rbrian/uChaser/README.md

# uFollow
Follow the project here: https://hackaday.io/project/190427-uchaser-ultrasonic-following-control-system
