rbrian/uChaser/prototype/Boards/TXRX BOM.xlsx

Sheet: Transmit US
Source: | D:\Projects\Ultrasonic-Direction-Finder-Module\Boards\Transmit US\Transmit US.kicad_sch
Date: | 2022-05-10 21:03
Tool: | Eeschema (6.0.2)
Generator: | C:\Program Files\KiCad\6.0\bin\scripting\plugins/bom_csv_grouped_by_value.py
Component Count: | 20
Individual Components:
Item | Qty | Reference(s) | Value | LibPart | Footprint | Datasheet | DK PN | MFG | MFG PN
 |  | C1 | 1u | Device:C | Capacitor_SMD:C_0603_1608Metric_Pad1.08x0.95mm_HandSolder | ~ | 478-1412-1-ND | AVX | 0805ZD105KAT2A
 |  | C2 | 1u | Device:C | Capacitor_SMD:C_0603_1608Metric_Pad1.08x0.95mm_HandSolder | ~ | 478-12799-1-ND | AVX | 0805ZD105KAT2A
 |  | C3 | 1u | Device:C | Capacitor_SMD:C_0603_1608Metric_Pad1.08x0.95mm_HandSolder | ~ | 478-1412-1-ND | AVX | 0805ZD104KAT2A
 |  | C4 | 1u | Device:C | Capacitor_SMD:C_0603_1608Metric_Pad1.08x0.95mm_HandSolder | ~ | 478-1412-1-ND | AVX | 0805ZD105KAT2A
 |  | C5 | 1u | Device:C | Capacitor_SMD:C_0603_1608Metric_Pad1.08x0.95mm_HandSolder | ~ | 478-1412-1-ND | AVX | 0805ZD105KAT2A
 |  | FID1 | Fiducial | Mechanical:Fiducial | Fiducial:Fiducial_1mm_Mask2mm | ~
 |  | FID2 | Fiducial | Mechanical:Fiducial | Fiducial:Fiducial_1mm_Mask2mm | ~
 |  | FID3 | Fiducial | Mechanical:Fiducial | Fiducial:Fiducial_1mm_Mask2mm | ~
 |  | H1 | GND | Mechanical:MountingHole_Pad | TestPoint:TestPoint_Keystone_5005-5009_Compact | ~
 |  | H2 | MountingHole | Mechanical:MountingHole | MountingHole:MountingHole_3.2mm_M3 | ~
 |  | H3 | MountingHole | Mechanical:MountingHole | MountingHole:MountingHole_3.2mm_M3 | ~
 |  | H4 | MountingHole | Mechanical:MountingHole | MountingHole:MountingHole_3.2mm_M3 | ~
 |  | H5 | MountingHole | Mechanical:MountingHole | MountingHole:MountingHole_3.2mm_M3 | ~
 |  | J1 | Phoenix 1984620 | Connector:Screw_Terminal_01x03 | Connector_PinHeader_2.54mm:PinHeader_1x03_P2.54mm_Vertical | ~
 |  | LS1 | USTransducer | uFinder:USTransducer | uFinder:ULTRASONIC_16MM
 |  | R1 | 0 | Device:R_US | Resistor_SMD:R_0603_1608Metric_Pad0.98x0.95mm_HandSolder | ~ | 311-51.0CRCT-ND | Yageo | RC0805FR-0751RL
 |  | R2 | 0 | Device:R_US | Resistor_SMD:R_0603_1608Metric_Pad0.98x0.95mm_HandSolder | ~ | 311-51.0CRCT-ND | Yageo | RC0805FR-0751RL
 |  | R3 | NP | Device:R_US | Resistor_SMD:R_0603_1608Metric_Pad0.98x0.95mm_HandSolder | ~ | NA | NA | NA
 |  | U1 | 74AHC1G04 | uFinder:74AHC1G04 | Package_TO_SOT_SMD:SOT-353_SC-70-5_Handsoldering | https://www.diodes.com/assets/Datasheets/74AHC1G04.pdf
 |  | U2 | MAX232 | Interface_UART:MAX232 | Package_SO:TSSOP-16_4.4x5mm_P0.65mm | https://www.renesas.com/us/en/document/dst/icl3221-icl3222-icl3223-icl3232-icl3241-icl3243-datasheet | ICL3232IVZ-ND | Renesas | ICL3232IVZ
Collated Components:
 |  |  |  |  |  |  |  |  |  |  | Num Boards | 12
Item | Qty | Reference(s) | Value | LibPart | Footprint | Datasheet | DK PN | MFG | MFG PN | Cost (10+) | Ext Cost | Notes
1 | 5 | C1, C2, C3, C4, C5 | 1u | Device:C | Capacitor_SMD:C_0603_1608Metric_Pad1.08x0.95mm_HandSolder | ~ | 1276-1102-1-ND | Samsung | CL10A105KA8NNNC | 0.034 | 2.04
2 | 3 | FID1, FID2, FID3 | Fiducial | Mechanical:Fiducial | Fiducial:Fiducial_1mm_Mask2mm | ~ | NA | NA | NA | 0 | 0
3 | 1 | H1 | GND | Mechanical:MountingHole_Pad | TestPoint:TestPoint_Keystone_5005-5009_Compact | ~ | 36-1041-ND | Keystone | 1041 | 0.2632 | 3.1584
4 | 4 | H2, H3, H4, H5 | MountingHole | Mechanical:MountingHole | MountingHole:MountingHole_3.2mm_M3 | ~ | NA | NA | NA | 0 | 0
5 | 1 | J1 | Phoenix 1984620 | Connector:Screw_Terminal_01x03 | Connector_PinHeader_2.54mm:PinHeader_1x03_P2.54mm_Vertical | ~ | 277-1722-ND | Phoenix | 1984620 | 0.782 | 9.384
6 | 1 | LS1 | USTransducer | uFinder:USTransducer | uFinder:ULTRASONIC_16MM |  |  |  |  |  | 0 | Amazon
7 | 2 | R1, R2 | 0 | Device:R_US | Resistor_SMD:R_0603_1608Metric_Pad0.98x0.95mm_HandSolder | ~ | 311-0.0HRCT-ND | Yageo | RC0603FR-070RL | 0.018 | 0.432
8 | 1 | R3 | NP | Device:R_US | Resistor_SMD:R_0603_1608Metric_Pad0.98x0.95mm_HandSolder | ~ | NA | NA | NA | 0 | 0
9 | 1 | U1 | 74AHC1G04 | uFinder:74AHC1G04 | Package_TO_SOT_SMD:SOT-353_SC-70-5_Handsoldering | https://www.ti.com/general/docs/suppproductinfo.tsp?distId=10 | 296-17248-1-ND | TI | SN74AHC1G04QDCKRQ1 | 0.41 | 4.92
10 | 1 | U2 | MAX232 | Interface_UART:MAX232 | Package_SO:TSSOP-16_4.4x5mm_P0.65mm | https://www.renesas.com/us/en/document/dst/icl3221-icl3222-icl3223-icl3232-icl3241-icl3243-datasheet | ICL3232IVZ-ND | Renesas | ICL3232IVZ | 1.854 | 22.248

Sheet: Receive US
Source: | D:\Projects\Ultrasonic-Direction-Finder-Module\Boards\Receive US\Receive US.kicad_sch
Date: | 2022-05-10 20:59
Tool: | Eeschema (6.0.2)
Generator: | C:\Program Files\KiCad\6.0\bin\scripting\plugins/bom_csv_grouped_by_value.py
Component Count: | 39
Individual Components:
Item | Qty | Reference(s) | Value | LibPart | Footprint | Datasheet
 |  | C1 | 3.3nF | Device:C | Capacitor_SMD:C_0603_1608Metric_Pad1.08x0.95mm_HandSolder | ~
 |  | C2 | 1uF | Device:C | Capacitor_SMD:C_0603_1608Metric_Pad1.08x0.95mm_HandSolder | ~
 |  | C3 | 0.1uF | Device:C | Capacitor_SMD:C_0603_1608Metric_Pad1.08x0.95mm_HandSolder | ~
 |  | C4 | 1uF | Device:C | Capacitor_SMD:C_0603_1608Metric_Pad1.08x0.95mm_HandSolder | ~
 |  | C5 | 390pF | Device:C | Capacitor_SMD:C_0603_1608Metric_Pad1.08x0.95mm_HandSolder | ~
 |  | C6 | 390pF | Device:C | Capacitor_SMD:C_0603_1608Metric_Pad1.08x0.95mm_HandSolder | ~
 |  | C7 | 3.3nF | Device:C | Capacitor_SMD:C_0603_1608Metric_Pad1.08x0.95mm_HandSolder | ~
 |  | C8 | 0.1uF | Device:C | Capacitor_SMD:C_0603_1608Metric_Pad1.08x0.95mm_HandSolder | ~
 |  | C9 | 1uF | Device:C | Capacitor_SMD:C_0603_1608Metric_Pad1.08x0.95mm_HandSolder | ~
 |  | D1 | SDMK0340L-7-F | Device:D_Schottky | Diode_SMD:D_SOD-323_HandSoldering | ~
 |  | FID1 | Fiducial | Mechanical:Fiducial | Fiducial:Fiducial_1mm_Mask2mm | ~
 |  | FID2 | Fiducial | Mechanical:Fiducial | Fiducial:Fiducial_1mm_Mask2mm | ~
 |  | FID3 | Fiducial | Mechanical:Fiducial | Fiducial:Fiducial_1mm_Mask2mm | ~
 |  | H1 | MountingHole_Pad | Mechanical:MountingHole_Pad | TestPoint:TestPoint_Keystone_5005-5009_Compact | ~
 |  | H2 | MountingHole | Mechanical:MountingHole | MountingHole:MountingHole_3.2mm_M3 | ~
 |  | H3 | MountingHole | Mechanical:MountingHole | MountingHole:MountingHole_3.2mm_M3 | ~
 |  | H4 | MountingHole | Mechanical:MountingHole | MountingHole:MountingHole_3.2mm_M3 | ~
 |  | H5 | MountingHole | Mechanical:MountingHole | MountingHole:MountingHole_3.2mm_M3 | ~
 |  | J1 | Phoenix 1984633 | Connector:Screw_Terminal_01x04 | Connector_PinHeader_2.54mm:PinHeader_1x04_P2.54mm_Vertical | ~
 |  | LS1 | USTransducer | uFinder:USTransducer | uFinder:ULTRASONIC_16MM
 |  | Q1 | BC848BLT3G | Device:Q_NPN_BEC | Package_TO_SOT_SMD:SOT-23 | ~
 |  | R1 | 10K | Device:R_US | Resistor_SMD:R_0603_1608Metric_Pad0.98x0.95mm_HandSolder | ~
 |  | R2 | 10K | Device:R_US | Resistor_SMD:R_0603_1608Metric_Pad0.98x0.95mm_HandSolder | ~
 |  | R3 | 10K | Device:R_US | Resistor_SMD:R_0603_1608Metric_Pad0.98x0.95mm_HandSolder | ~
 |  | R4 | 3.3K | Device:R_US | Resistor_SMD:R_0603_1608Metric_Pad0.98x0.95mm_HandSolder | ~
 |  | R5 | 75K | Device:R_US | Resistor_SMD:R_0603_1608Metric_Pad0.98x0.95mm_HandSolder | ~
 |  | R6 | 1K | Device:R_US | Resistor_SMD:R_0603_1608Metric_Pad0.98x0.95mm_HandSolder | ~
 |  | R7 | 4.7K | Device:R_US | Resistor_SMD:R_0603_1608Metric_Pad0.98x0.95mm_HandSolder | ~
 |  | R8 | 1K | Device:R_US | Resistor_SMD:R_0603_1608Metric_Pad0.98x0.95mm_HandSolder | ~
 |  | R9 | 75K | Device:R_US | Resistor_SMD:R_0603_1608Metric_Pad0.98x0.95mm_HandSolder | ~
 |  | R10 | 1K | Device:R_US | Resistor_SMD:R_0603_1608Metric_Pad0.98x0.95mm_HandSolder | ~
 |  | R11 | 75K | Device:R_US | Resistor_SMD:R_0603_1608Metric_Pad0.98x0.95mm_HandSolder | ~
 |  | R12 | 10K | Device:R_US | Resistor_SMD:R_0603_1608Metric_Pad0.98x0.95mm_HandSolder | ~
 |  | R13 | 10K | Device:R_US | Resistor_SMD:R_0603_1608Metric_Pad0.98x0.95mm_HandSolder | ~
 |  | TP1 | VSTG1 | Connector:TestPoint | TestPoint:TestPoint_Keystone_5005-5009_Compact | ~
 |  | TP2 | VSTG2 | Connector:TestPoint | TestPoint:TestPoint_Keystone_5005-5009_Compact | ~
 |  | TP3 | VENV | Connector:TestPoint | TestPoint:TestPoint_Keystone_5005-5009_Compact | ~
 |  | U1 | OPA2316SIDGSR | uFinder:TLV9002SIDGSR | uFinder:TLV9002SIDGSR
 |  | U2 | OPA2316SIDGSR | uFinder:TLV9002SIDGSR | uFinder:TLV9002SIDGSR
Collated Components:
 |  |  |  |  |  |  |  |  |  |  | Num Boards | 12
Item | Qty | Reference(s) | Value | LibPart | Footprint | Datasheet | DK PN | MFG | MFG PN | Cost (10+) | Ext Cost | Notes
1 | 2 | C1, C7 | 3.3nF | Device:C | Capacitor_SMD:C_0603_1608Metric_Pad1.08x0.95mm_HandSolder | ~ | 1276-1758-1-ND | Samsung | CL10B332KB8NNNC | 0.1 | 2.4
2 | 3 | C2, C4, C9 | 1uF | Device:C | Capacitor_SMD:C_0603_1608Metric_Pad1.08x0.95mm_HandSolder | ~ | 1276-1102-1-ND | Samsung | CL10A105KA8NNNC | 0.034 | 1.224
3 | 2 | C3, C8 | 0.1uF | Device:C | Capacitor_SMD:C_0603_1608Metric_Pad1.08x0.95mm_HandSolder | ~ | 587-1245-1-ND | TDK | TMK107BJ104KA-T | 0.038 | 0.912
4 | 2 | C5, C6 | 390pF | Device:C | Capacitor_SMD:C_0603_1608Metric_Pad1.08x0.95mm_HandSolder | ~ | 1276-2049-1-ND | Samsung | CL10B391KB8NNNC | 0.04 | 0.96
5 | 1 | D1 | SDMK0340L-7-F | Device:D_Schottky | Diode_SMD:D_SOD-323_HandSoldering | ~ | CUS05S30H3FCT-ND | Toshiba | CUS05S30,H3F | 0.272 | 3.264
6 | 3 | FID1, FID2, FID3 | Fiducial | Mechanical:Fiducial | Fiducial:Fiducial_1mm_Mask2mm | ~ | NA | NA | NA | 0 | 0
7 | 4 | H1, TP1, TP2, TP3 | MountingHole_Pad | Mechanical:MountingHole_Pad | TestPoint:TestPoint_Keystone_5005-5009_Compact | ~ | 36-1041-ND | Keystone | 1041 | 0.2632 | 12.6336
8 | 4 | H2, H3, H4, H5 | MountingHole | Mechanical:MountingHole | MountingHole:MountingHole_3.2mm_M3 | ~ | NA | NA | NA | 0 | 0
9 | 1 | J1 | Phoenix 1984633 | Connector:Screw_Terminal_01x04 | Connector_PinHeader_2.54mm:PinHeader_1x04_P2.54mm_Vertical | ~ | 277-1860-ND | Phoenix | 1984633 | 1.035 | 12.42
10 | 1 | LS1 | USTransducer | uFinder:USTransducer | uFinder:ULTRASONIC_16MM |  |  |  |  |  | 0 | Amazon
11 | 1 | Q1 | BC848BLT3G | Device:Q_NPN_BEC | Package_TO_SOT_SMD:SOT-23 | ~ | BC848BLT3GOSCT-ND | OnSemi | BC848BLT3G | 0.11 | 1.32
12 | 5 | R1, R2, R3, R12, R13 | 10K | Device:R_US | Resistor_SMD:R_0603_1608Metric_Pad0.98x0.95mm_HandSolder | ~ | 13-RC0603FR-1310KLCT-ND | Yageo | RC0603FR-1310KL | 0.024 | 1.44
13 | 1 | R4 | 3.3K | Device:R_US | Resistor_SMD:R_0603_1608Metric_Pad0.98x0.95mm_HandSolder | ~ | 13-RC0603FR-103K3LCT-ND | Yageo | RC0603FR-103K3L | 0.024 | 0.288
14 | 3 | R5, R9, R11 | 75K | Device:R_US | Resistor_SMD:R_0603_1608Metric_Pad0.98x0.95mm_HandSolder | ~ | 13-RC0603FR-1075KLCT-ND | Yageo | RC0603FR-1075KL | 0.024 | 0.864
15 | 3 | R6, R8, R10 | 1K | Device:R_US | Resistor_SMD:R_0603_1608Metric_Pad0.98x0.95mm_HandSolder | ~ | 13-RC0603FR-131KLCT-ND | Yageo | RC0603FR-131KL | 0.024 | 0.864
16 | 1 | R7 | 4.7K | Device:R_US | Resistor_SMD:R_0603_1608Metric_Pad0.98x0.95mm_HandSolder | ~ | 13-RC0603FR-134K7LCT-ND | Yageo | RC0603FR-134K7L | 0.024 | 0.288
20 | 2 | U1, U2 | TLV9052SIDGSR | uFinder:TLV9002SIDGSR | uFinder:TLV9002SIDGSR |  | 296-TLV9052SIDGSRCT-ND | TI | TLV9052SIDGSR | 0.81 | 19.44

Sheet: Combined
 | Board Qty | Combined Qty | 12 Sets | LCSC | Digikey | Mouser
1 | 5 | 8 | 96 | X |  |  | C1, C2, C3, C4, C5 | 1u | Device:C | Capacitor_SMD:C_0603_1608Metric_Pad1.08x0.95mm_HandSolder | ~ | 478-1412-1-ND | AVX | 0805ZD105KAT2A
3 | 1 | 5 | 60 |  | x |  | H1 | GND | Mechanical:MountingHole_Pad | TestPoint:TestPoint_Keystone_5005-5009_Compact | ~
5 | 1 |  |  |  |  |  | J1 | Phoenix 1984620 | Connector:Screw_Terminal_01x03 | Connector_PinHeader_2.54mm:PinHeader_1x03_P2.54mm_Vertical | ~
6 | 1 |  |  |  |  |  | LS1 | USTransducer | uFinder:USTransducer | uFinder:ULTRASONIC_16MM
7 | 2 | 2 | 24 | X |  |  | R1, R2 | 0 | Device:R_US | Resistor_SMD:R_0603_1608Metric_Pad0.98x0.95mm_HandSolder | ~ | 311-51.0CRCT-ND | Yageo | RC0805FR-0751RL
8 | 1 |  |  |  |  |  | R3 | NP | Device:R_US | Resistor_SMD:R_0603_1608Metric_Pad0.98x0.95mm_HandSolder | ~ | NA | NA | NA
9 | 1 | 1 | 12 |  |  |  | U1 | 74AHC1G04 | uFinder:74AHC1G04 | Package_TO_SOT_SMD:SOT-353_SC-70-5_Handsoldering | https://www.diodes.com/assets/Datasheets/74AHC1G04.pdf |  |  |  | https://www.onsemi.com/pdf/datasheet/mc74hc1gu04-d.pdf
10 | 1 | 1 | 12 | X |  |  | U2 | MAX232 | Interface_UART:MAX232 | Package_SO:TSSOP-16_4.4x5mm_P0.65mm | http://www.ti.com/lit/ds/symlink/max232.pdf | 296-19263-1-ND | TI | MAX3232ECPWR
1 | 2 | 2 | 24 | X |  |  | C1, C7 | 3.3nF | Device:C | Capacitor_SMD:C_0603_1608Metric_Pad1.08x0.95mm_HandSolder | ~
2 | 3 | x |  |  |  |  | C2, C4, C9 | 1uF | Device:C | Capacitor_SMD:C_0603_1608Metric_Pad1.08x0.95mm_HandSolder | ~
3 | 2 | 2 | 24 | X |  |  | C3, C8 | 0.1uF | Device:C | Capacitor_SMD:C_0603_1608Metric_Pad1.08x0.95mm_HandSolder | ~
4 | 2 | 2 | 24 | X |  |  | C5, C6 | 390pF | Device:C | Capacitor_SMD:C_0603_1608Metric_Pad1.08x0.95mm_HandSolder | ~
5 | 1 | 1 | 12 |  |  |  | D1 | SDMK0340L-7-F | Device:D_Schottky | Diode_SMD:D_SOD-323_HandSoldering | ~
7 | 1 | x |  |  |  |  | H1 | MountingHole_Pad | Mechanical:MountingHole_Pad | TestPoint:TestPoint_Keystone_5005-5009_Compact | ~
9 | 1 |  |  |  |  |  | J1 | Phoenix 1984633 | Connector:Screw_Terminal_01x04 | Connector_PinHeader_2.54mm:PinHeader_1x04_P2.54mm_Vertical | ~
10 | 1 |  |  |  |  |  | LS1 | USTransducer | uFinder:USTransducer | uFinder:ULTRASONIC_16MM
11 | 1 | 1 | 12 |  |  | x | Q1 | BC848BLT3G | Device:Q_NPN_BEC | Package_TO_SOT_SMD:SOT-23 | ~
12 | 5 | 5 | 60 | X |  |  | R1, R2, R3, R12, R13 | 10K | Device:R_US | Resistor_SMD:R_0603_1608Metric_Pad0.98x0.95mm_HandSolder | ~
13 | 1 | 1 | 12 | X |  |  | R4 | 3.3K | Device:R_US | Resistor_SMD:R_0603_1608Metric_Pad0.98x0.95mm_HandSolder | ~
14 | 3 | 3 | 36 | X |  |  | R5, R9, R11 | 75K | Device:R_US | Resistor_SMD:R_0603_1608Metric_Pad0.98x0.95mm_HandSolder | ~
15 | 3 | 3 | 36 | X |  |  | R6, R8, R10 | 1K | Device:R_US | Resistor_SMD:R_0603_1608Metric_Pad0.98x0.95mm_HandSolder | ~
16 | 1 | 1 | 12 | X |  |  | R7 | 4.7K | Device:R_US | Resistor_SMD:R_0603_1608Metric_Pad0.98x0.95mm_HandSolder | ~
17 | 1 | x |  |  |  |  | TP1 | VSTG1 | Connector:TestPoint | TestPoint:TestPoint_Keystone_5005-5009_Compact | ~
18 | 1 | x |  |  |  |  | TP2 | VSTG2 | Connector:TestPoint | TestPoint:TestPoint_Keystone_5005-5009_Compact | ~
19 | 1 | x |  |  |  |  | TP3 | VENV | Connector:TestPoint | TestPoint:TestPoint_Keystone_5005-5009_Compact | ~
20 | 2 | 2 | 24 |  | x |  | U1, U2 | OPA2316SIDGSR | uFinder:TLV9002SIDGSR | uFinder:TLV9002SIDGSR
