rbrian/uChaser/prototype/Boards/3d models/ESP32-S3-WROOM-1-N4R2.step

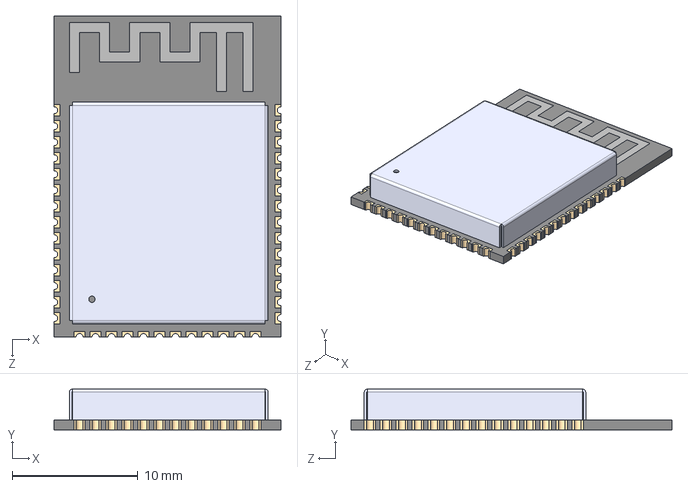
[picture p2: CAD file, 2023-04-07]
prototype/Boards/3d models/ESP32-S3-WROOM-1-N4R2.step
18.0 x 3.25 x 25.5 mm
