rbrian/uChaser/prototype/Boards/Transmit US/Transmit US.pdf

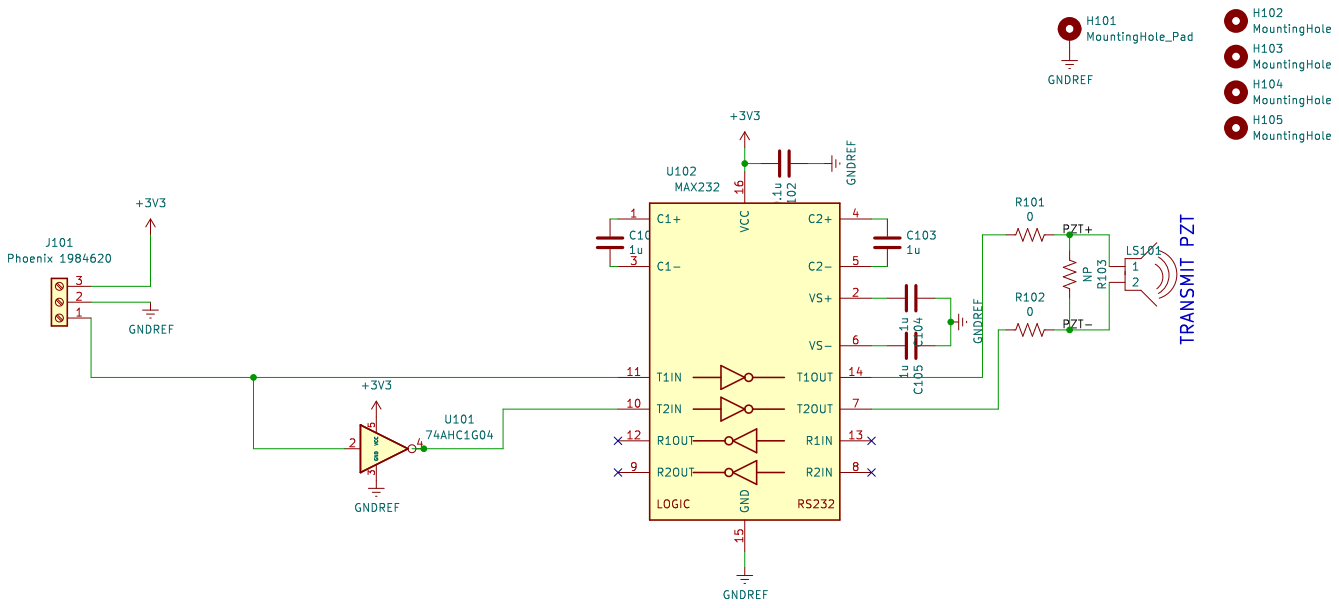
[picture p3: page 1]
