rbrian/uChaser/prototype/Boards/Receive US/schematic 0.1.pdf

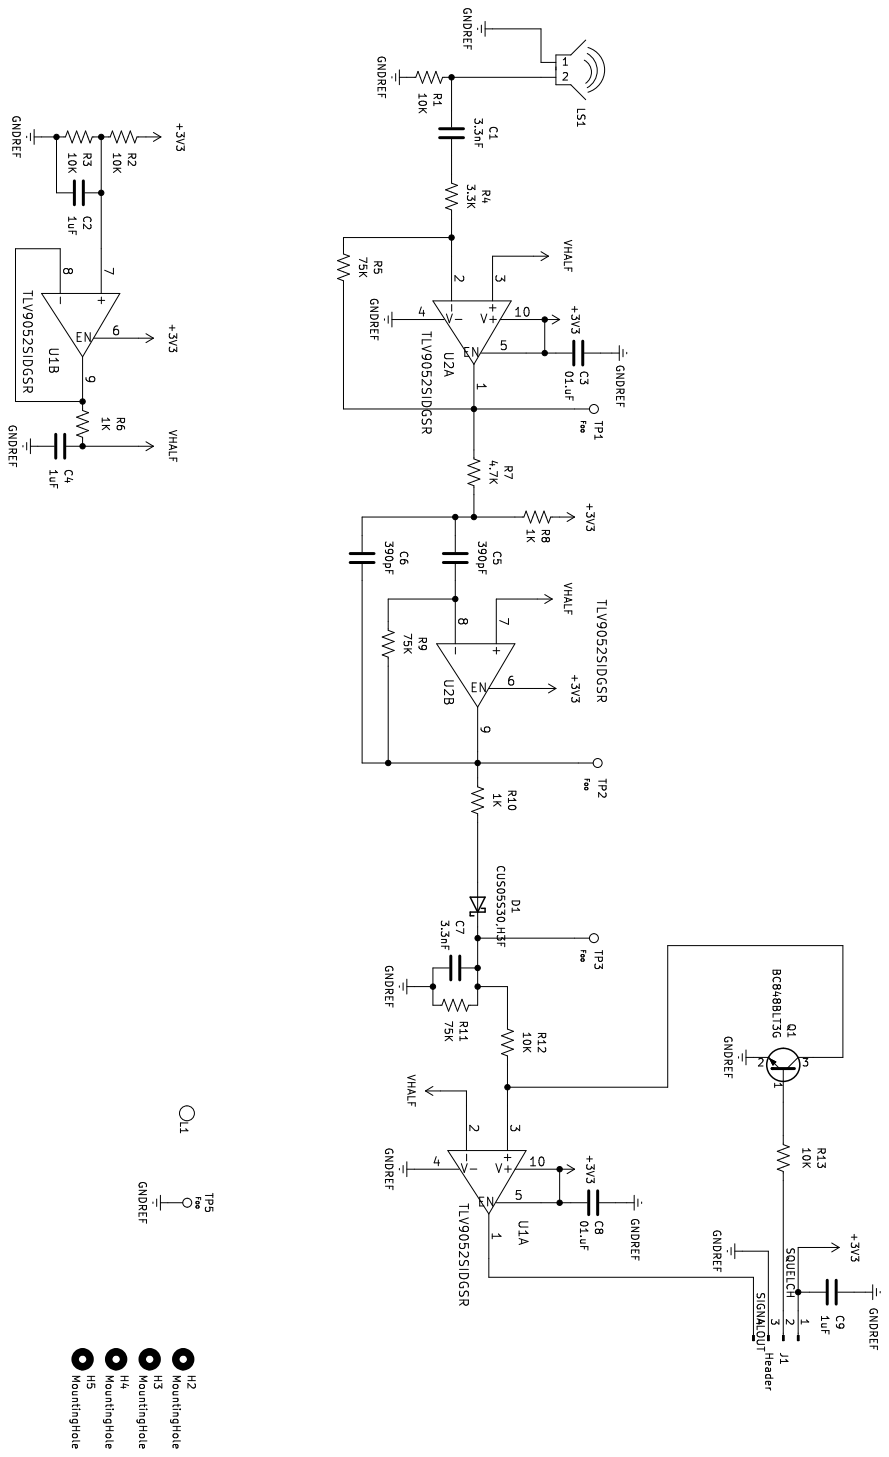
[picture p4: page 1]
