rbrian/uChaser/prototype/Boards/Receive US/Receive US.kicad_pcb

## KiCad design prototype/Boards/Receive US/Receive US.kicad_pcb (2023-04-07, an earlier design)

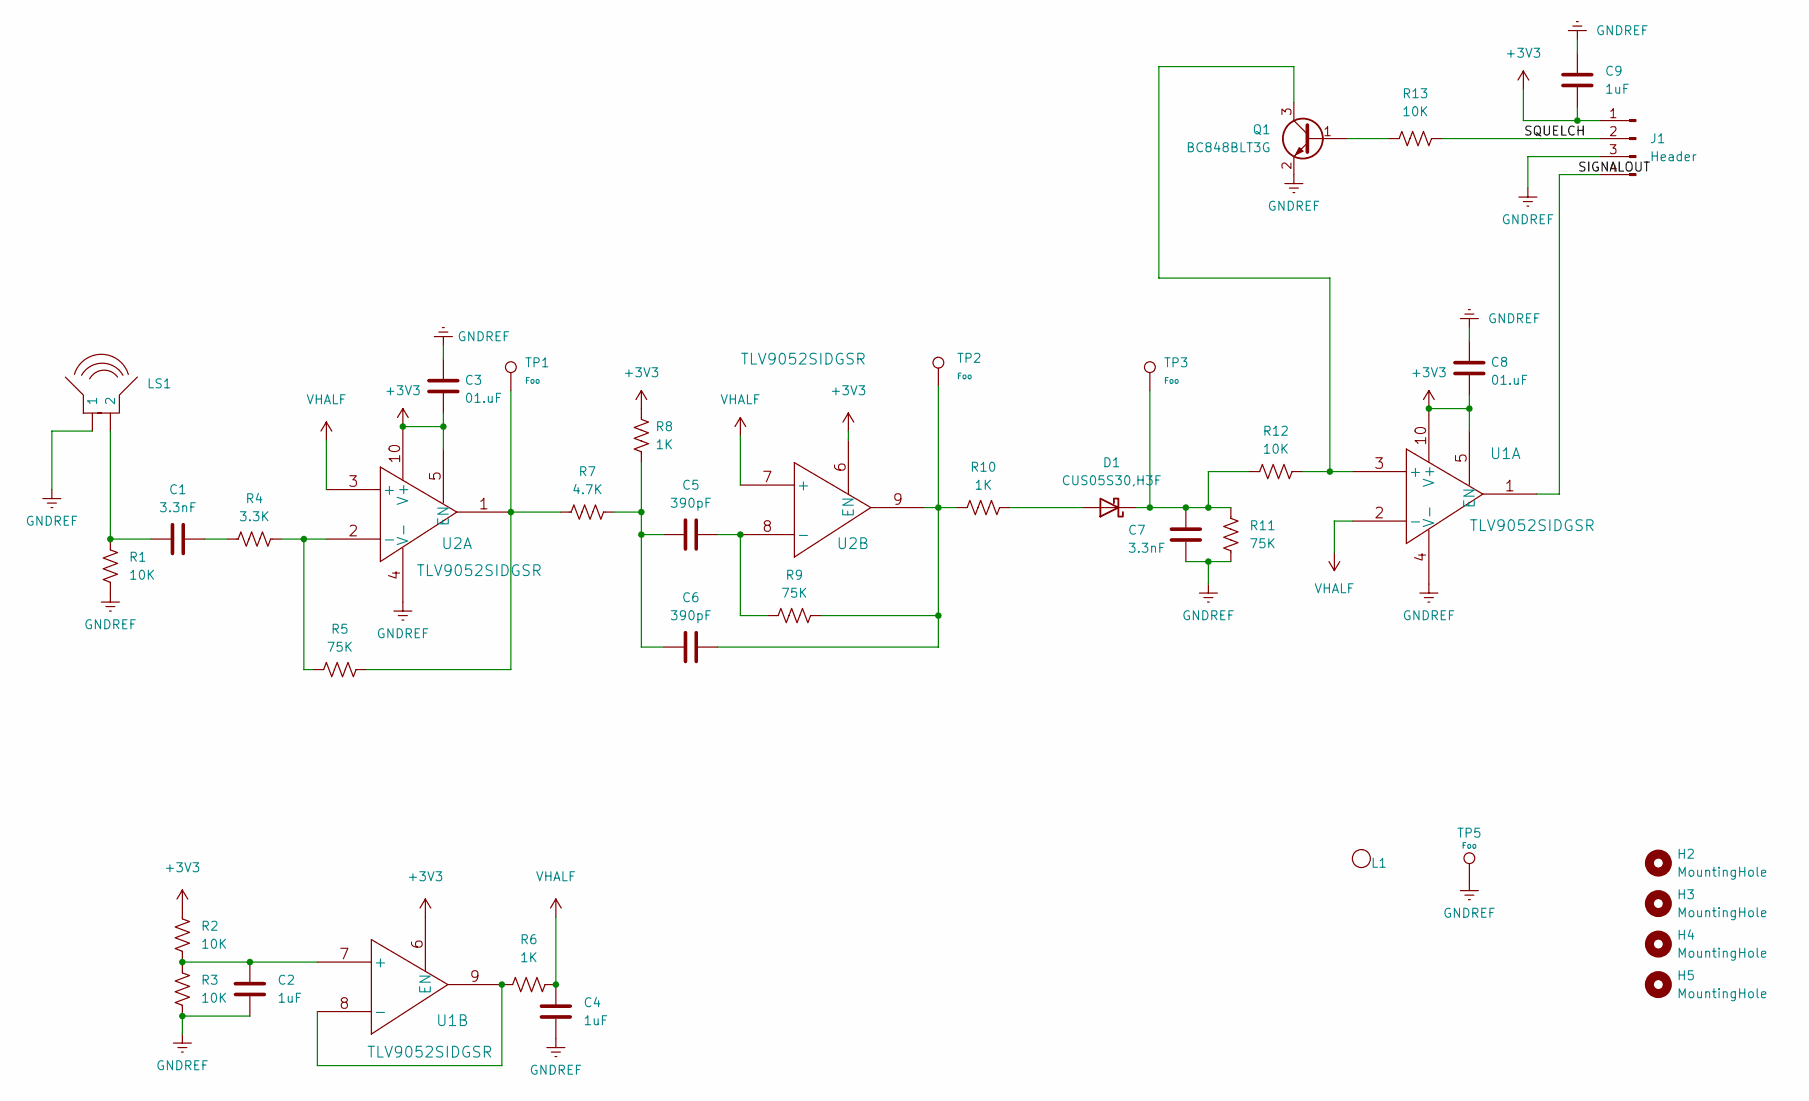
[picture p5: schematic Receive US.kicad_sch]

Parts:
C1, C7: 3.3nF; C_0603_1608Metric_Pad1.08x0.95mm_HandSolder; MFG PN CL10B332KB8NNNC
C2, C4, C9: 1uF; C_0603_1608Metric_Pad1.08x0.95mm_HandSolder; MFG PN CL10A105KA8NNNC
C3, C8: 01.uF; C_0603_1608Metric_Pad1.08x0.95mm_HandSolder; MFG PN TMK107BJ104KA-T
C5, C6: 390pF; C_0603_1608Metric_Pad1.08x0.95mm_HandSolder; MFG PN CL10B391KB8NNNC
D1: CUS05S30,H3F; D_SOD-323_HandSoldering; MFG PN CUS05S30,H3F
H2, H3, H4, H5: MountingHole; MountingHole_3.2mm_M3
J1: Header; PinHeader_1x04_P2.54mm_Vertical
L1: uFollowLogo
LS1: USTransducer; ULTRASONIC_16MM
Q1: BC848BLT3G; SOT-23; MFG PN BC848BLT3G
R1, R2, R3, R12, R13: 10K; R_0603_1608Metric_Pad0.98x0.95mm_HandSolder; MFG PN RC0603FR-1310KL
R4: 3.3K; R_0603_1608Metric_Pad0.98x0.95mm_HandSolder; MFG PN RC0603FR-103K3L
R5, R9, R11: 75K; R_0603_1608Metric_Pad0.98x0.95mm_HandSolder; MFG PN RC0603FR-1075KL
R6, R8, R10: 1K; R_0603_1608Metric_Pad0.98x0.95mm_HandSolder; MFG PN RC0603FR-131KL
R7: 4.7K; R_0603_1608Metric_Pad0.98x0.95mm_HandSolder; MFG PN RC0603FR-134K7L
TP1, TP2, TP3, TP5: TestPoint; TestPoint_Keystone_5005-5009_Compact; MFG PN 1041
U1, U2: TLV9052SIDGSR; TLV9002SIDGSR; MFG PN TLV9052SIDGSR

Connections:
+3V3: C3.1, C8.1, C9.1, J1.1, R2.2, R8.1, U1.5 (EN), U1.6 (EN), U1.10 (V+), U2.5 (EN), U2.6 (EN), U2.10 (V+)
/SIGNALOUT: J1.4, U1.1
/SQUELCH: J1.2, R13.2
GNDREF: C2.1, C3.2, C4.1, C7.1, C8.2, C9.2, J1.3, LS1.1, Q1.2 (E), R1.1, R3.1, R11.1, TP5.1, U1.4 (V-), U2.4 (V-)
unnamed: C1.1, LS1.2, R1.2
unnamed: C1.2, R4.1
unnamed: C5.1, C6.1, R7.2, R8.2
unnamed: C6.2, R9.2, R10.1, TP2.1, U2.9
unnamed: D1.2 (A), R10.2
unnamed: C7.2, D1.1 (K), R11.2, R12.1, TP3.1
unnamed: Q1.1 (B), R13.1
unnamed: Q1.3 (C), R12.2, U1.3 (+)
unnamed: R5.2, R7.1, TP1.1, U2.1
unnamed: C2.2, R2.1, R3.2, U1.7 (+)
unnamed: R6.2, U1.8 (-), U1.9
unnamed: R4.2, R5.1, U2.2 (-)
unnamed: C5.2, R9.1, U2.8 (-)
VHALF: C4.2, R6.1, U1.2 (-), U2.3 (+), U2.7 (+)

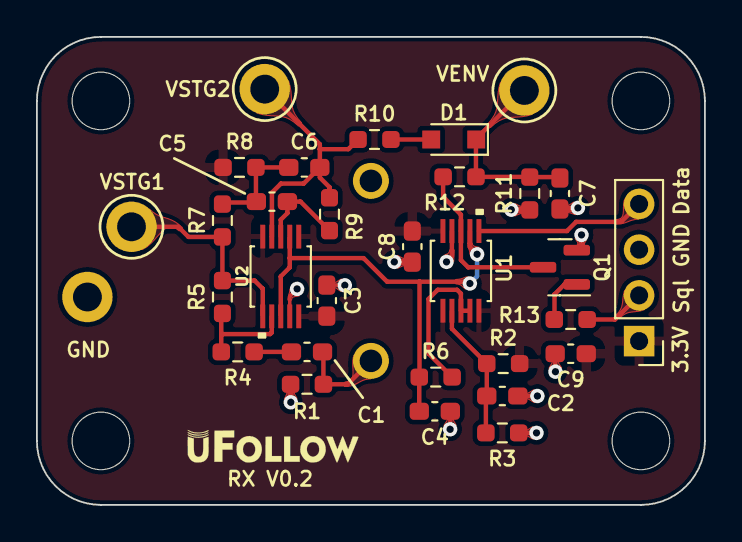
[picture p6: board Receive US.kicad_pcb from above]

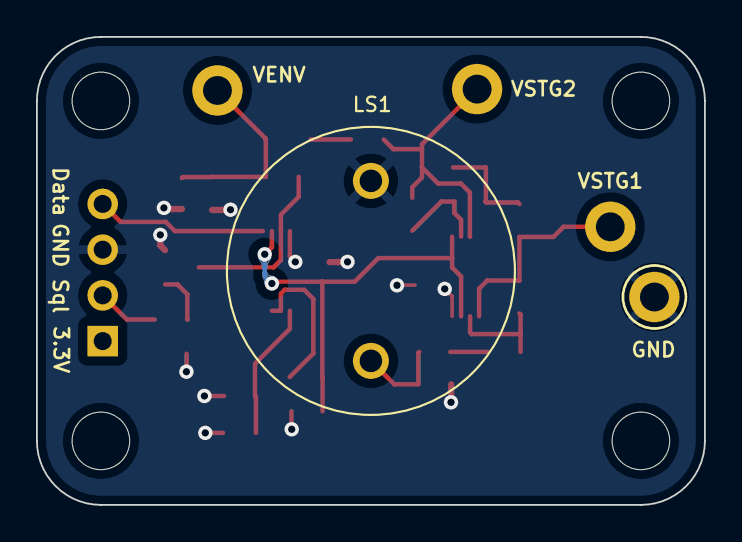
[picture p7: board Receive US.kicad_pcb from below]

Board: 2 copper layers, 37.1 x 26.0 mm, 37 parts (2 on the bottom side), 18 nets.
