rbrian/uChaser/prototype/Boards/Receive US v2/Receive US v2.kicad_pcb

## KiCad design prototype/Boards/Receive US v2/Receive US v2.kicad_pcb (2023-05-11)

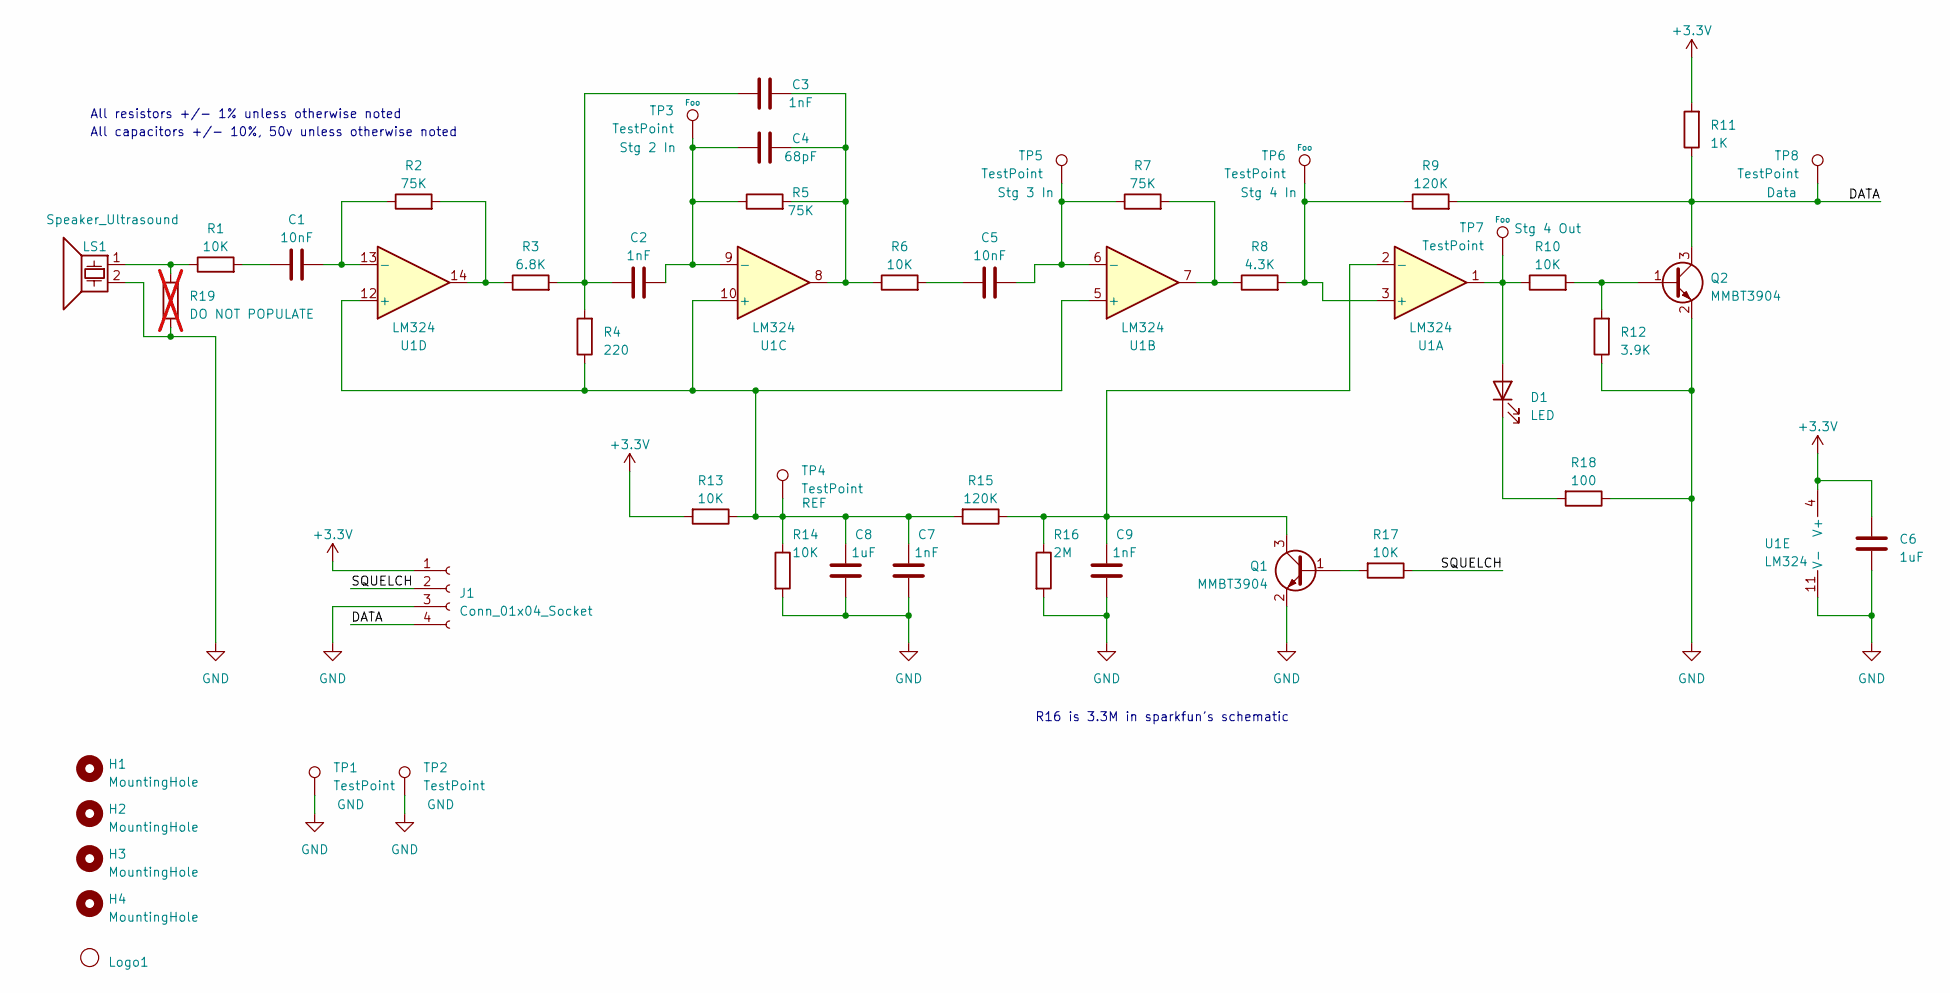
[picture p8: schematic Receive US v2.kicad_sch]

Parts:
C1, C5: 10nF; C_0805_2012Metric; LCSC C1710
C2, C3, C7, C9: 1nF; C_0805_2012Metric; LCSC C46653
C4: 68pF; C_0603_1608Metric; LCSC C28262
C6, C8: 1uF; C_0805_2012Metric; LCSC C28323
D1: LED; LED_0805_2012Metric; LCSC C84256
H1, H2, H3, H4: MountingHole; MountingHole_3.2mm_M3
J1: Conn_01x04_Socket; JST_XH_B4B-XH-A_1x04_P2.50mm_Vertical
LS1: Speaker_Ultrasound; ULTRASONIC_16MM
Logo1: logo
Q1, Q2: MMBT3904; SOT-23; LCSC C20526
R1, R6, R10, R13, R14, R17: 10K; R_0805_2012Metric; LCSC C17414
R2, R5, R7: 75K; R_0805_2012Metric; LCSC C17819
R3: 6.8K; R_0805_2012Metric; LCSC C17772
R4: 220; R_0805_2012Metric; LCSC C17557
R8: 4.3K; R_0805_2012Metric; LCSC C17667
R9, R15: 120K; R_0805_2012Metric; LCSC C17436
R11: 1K; R_0805_2012Metric; LCSC C17513
R12: 3.9K; R_0805_2012Metric; LCSC C17614
R16: 2M; R_0805_2012Metric; LCSC C26112
R18: 100; R_0805_2012Metric; LCSC C17408
R19: DO NOT POPULATE; R_0805_2012Metric; not fitted
TP1, TP2, TP3, TP4, TP5, TP6, TP7, TP8: TestPoint; TestPoint_THTPad_D1.5mm_Drill0.7mm
U1: LM324; SOIC-14_3.9x8.7mm_P1.27mm; LCSC C71035

Connections:
+3.3V: C6.2, J1.1, R11.2, R13.2, U1.4 (V+)
/DATA: J1.4, Q2.3 (C), R9.2, R11.1, TP8.1
/SQUELCH: J1.2, R17.1
GND: C6.1, C7.1, C8.1, C9.1, J1.3, LS1.2, Q1.2 (E), Q2.2 (E), R12.1, R14.2, R16.2, R18.1, R19.1, TP1.1, TP2.1, U1.11 (V-)
unnamed: C1.1, R1.2
unnamed: C2.1, C3.1, R3.2, R4.2
unnamed: C3.2, C4.2, R5.2, R6.1, U1.8
unnamed: C5.1, R6.2
unnamed: D1.2 (A), R10.1, TP7.1, U1.1
unnamed: D1.1 (K), R18.2
unnamed: LS1.1, R1.1, R19.2
unnamed: Q1.1 (B), R17.2
unnamed: C9.2, Q1.3 (C), R15.1, R16.1, U1.2 (-)
unnamed: Q2.1 (B), R10.2, R12.2
unnamed: R2.2, R3.1, U1.14
unnamed: R7.2, R8.1, U1.7
unnamed: R8.2, R9.1, TP6.1, U1.3 (+)
unnamed: C7.2, C8.2, R4.1, R13.1, R14.1, R15.2, TP4.1, U1.5 (+), U1.10 (+), U1.12 (+)
unnamed: C5.2, R7.1, TP5.1, U1.6 (-)
unnamed: C2.2, C4.1, R5.1, TP3.1, U1.9 (-)
unnamed: C1.2, R2.1, U1.13 (-)

Notes on the sheet:
All capacitors +/- 10%, 50v unless otherwise noted
All resistors +/- 1% unless otherwise noted
R16 is 3.3M in sparkfun's schematic

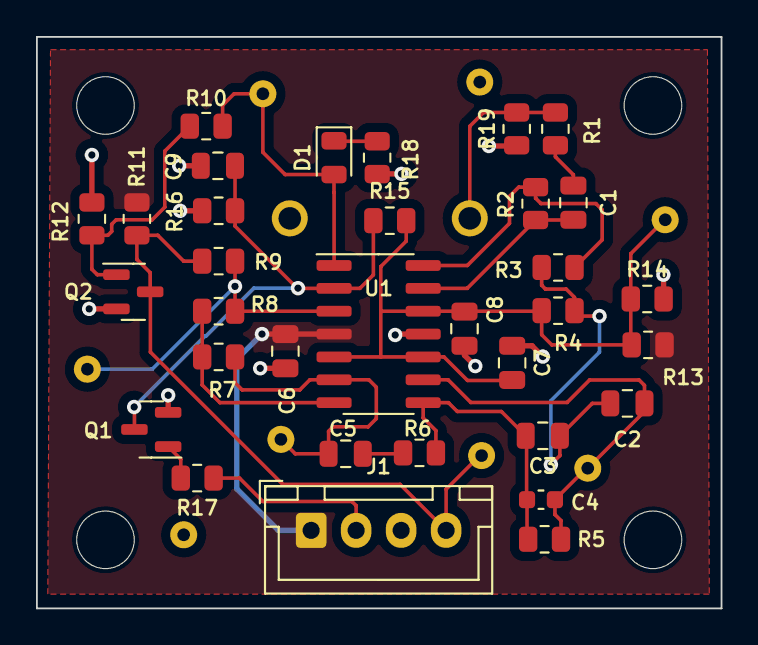
[picture p9: board Receive US v2.kicad_pcb from above]

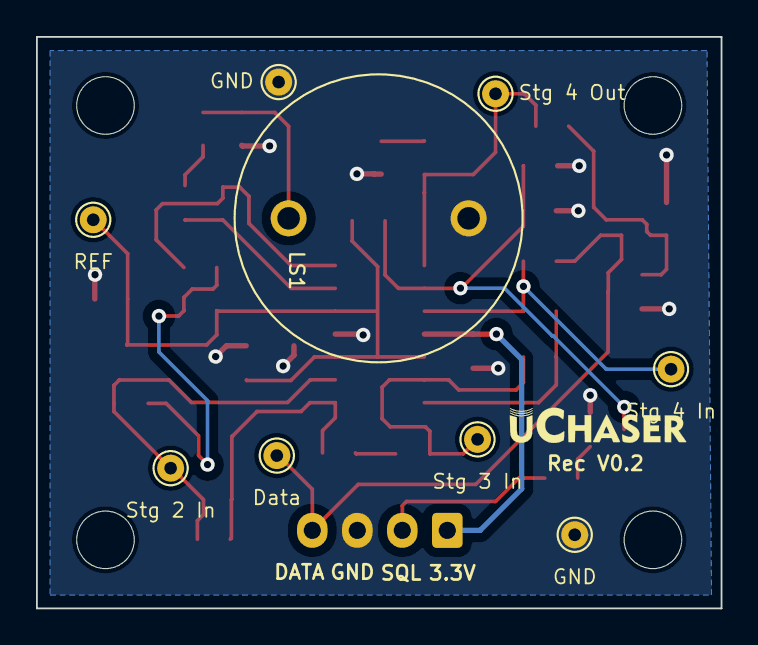
[picture p10: board Receive US v2.kicad_pcb from below]

Board: 2 copper layers, 38.0 x 31.7 mm, 47 parts (10 on the bottom side), 21 nets.
