rbrian/uChaser/Side projects/Transmit LEDs/Transmit LEDs.kicad_pcb

## KiCad design Side projects/Transmit LEDs/Transmit LEDs.kicad_pcb (2023-04-07)

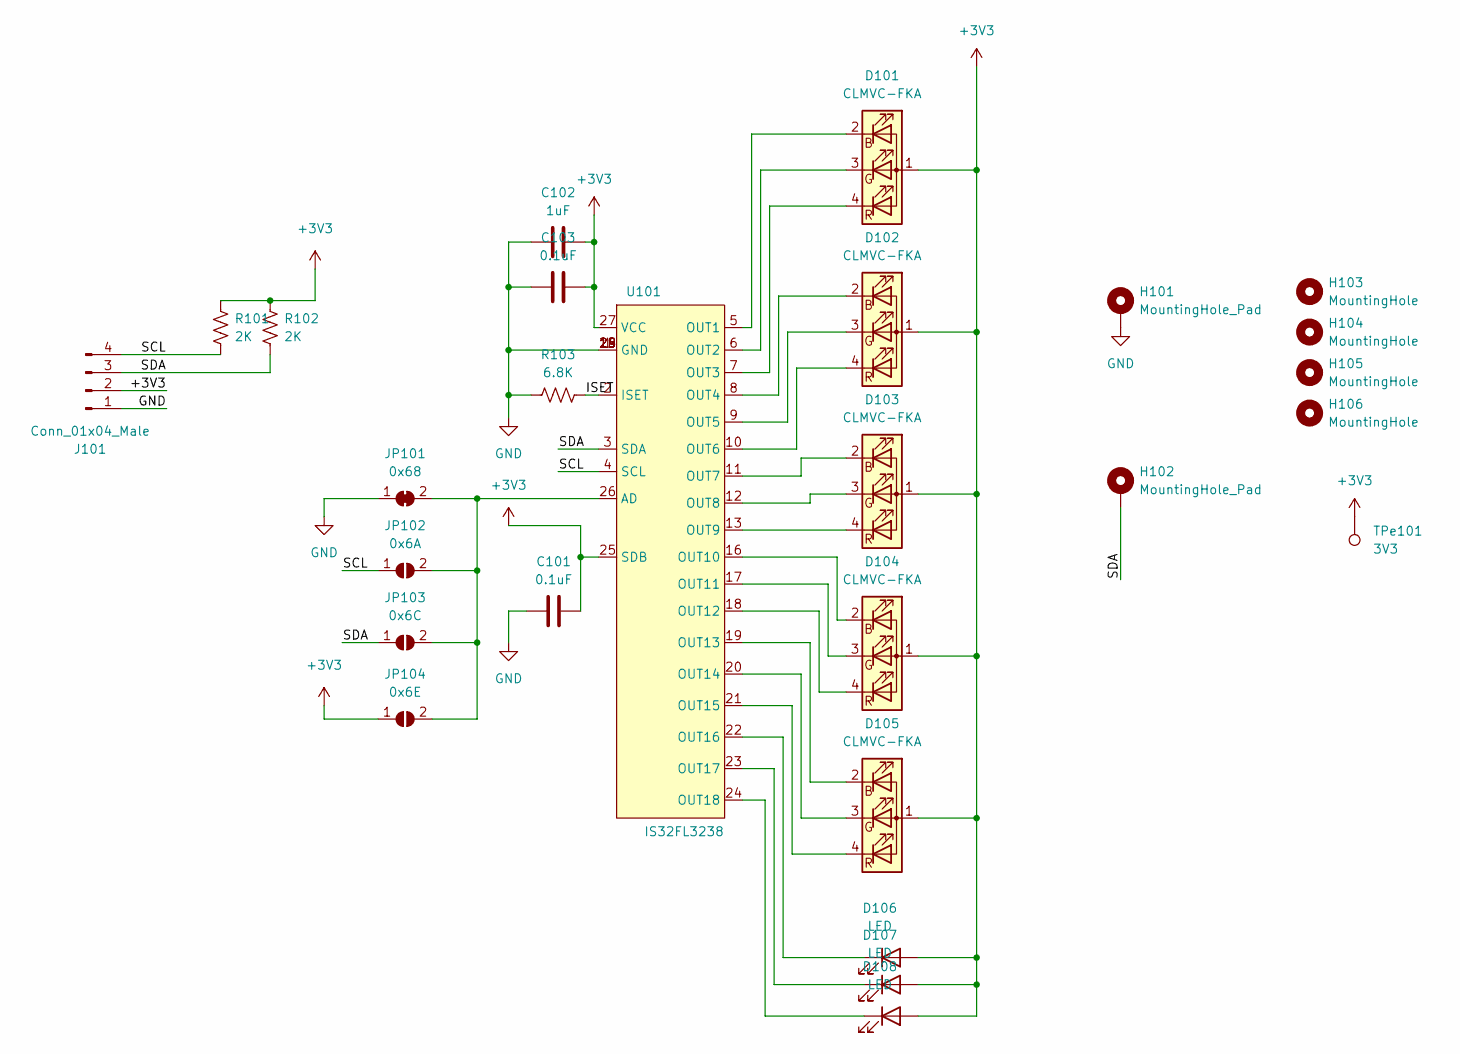
[picture p11: schematic Transmit LEDs.kicad_sch]

Parts:
C101, C103: 0.1uF; C_0805_2012Metric_Pad1.18x1.45mm_HandSolder
C102: 1uF; C_0805_2012Metric_Pad1.18x1.45mm_HandSolder
D101, D102, D103, D104, D105: CLMVC-FKA; LED_Cree-PLCC4_2x2mm_CW
D106, D107, D108: LED; LED_0805_2012Metric_Pad1.15x1.40mm_HandSolder
H101, H102: MountingHole_Pad; MountingHole_2.2mm_M2_DIN965_Pad_TopBottom
H103, H104, H105, H106: MountingHole; MountingHole_2.2mm_M2
J101: Conn_01x04_Male; JST_SH_SM04B-SRSS-TB_1x04-1MP_P1.00mm_Horizontal
JP101: 0x68; SolderJumper-2_P1.3mm_Bridged_RoundedPad1.0x1.5mm
JP102: 0x6A; SolderJumper-2_P1.3mm_Open_RoundedPad1.0x1.5mm
JP103: 0x6C; SolderJumper-2_P1.3mm_Open_RoundedPad1.0x1.5mm
JP104: 0x6E; SolderJumper-2_P1.3mm_Open_RoundedPad1.0x1.5mm
R101, R102: 2K; R_0805_2012Metric_Pad1.20x1.40mm_HandSolder
R103: 6.8K; R_0805_2012Metric_Pad1.20x1.40mm_HandSolder
TPe101: 3V3; TestPoint_Pad_D2.0mm
U101: IS32FL3238; TSSOP-28-1EP_4.4x9.7mm_P0.65mm_EP2.85x6.7mmVias

Connections:
+3V3: C101.1, C102.1, C103.1, D101.1 (A), D102.1 (A), D103.1 (A), D104.1 (A), D105.1 (A), D106.2 (A), D107.2 (A), D108.2 (A), J101.2, JP104.1 (A), R101.2, R102.2, TPe101.1, U101.25 (SDB), U101.27 (VCC)
/ISET: R103.2, U101.2 (ISET)
/SCL: J101.4, JP102.1 (A), R101.1, U101.4 (SCL)
/SDA: H102.1, J101.3, JP103.1 (A), R102.1, U101.3 (SDA)
GND: C101.2, C102.2, C103.2, H101.1, J101.1, JP101.1 (A), R103.1, U101.1 (GND), U101.14 (GND), U101.15 (GND), U101.28 (GND), U101.29 (GND)
unnamed: D101.2 (BK), U101.5 (OUT1)
unnamed: D101.3 (GK), U101.6 (OUT2)
unnamed: D101.4 (RK), U101.7 (OUT3)
unnamed: D102.2 (BK), U101.8 (OUT4)
unnamed: D102.3 (GK), U101.9 (OUT5)
unnamed: D102.4 (RK), U101.10 (OUT6)
unnamed: D103.2 (BK), U101.11 (OUT7)
unnamed: D103.3 (GK), U101.12 (OUT8)
unnamed: D103.4 (RK), U101.13 (OUT9)
unnamed: D104.2 (BK), U101.16 (OUT10)
unnamed: D104.3 (GK), U101.17 (OUT11)
unnamed: D104.4 (RK), U101.18 (OUT12)
unnamed: D105.2 (BK), U101.19 (OUT13)
unnamed: D105.3 (GK), U101.20 (OUT14)
unnamed: D105.4 (RK), U101.21 (OUT15)
unnamed: D106.1 (K), U101.22 (OUT16)
unnamed: D107.1 (K), U101.23 (OUT17)
unnamed: D108.1 (K), U101.24 (OUT18)
unnamed: JP101.2 (B), JP102.2 (B), JP103.2 (B), JP104.2 (B), U101.26 (AD)

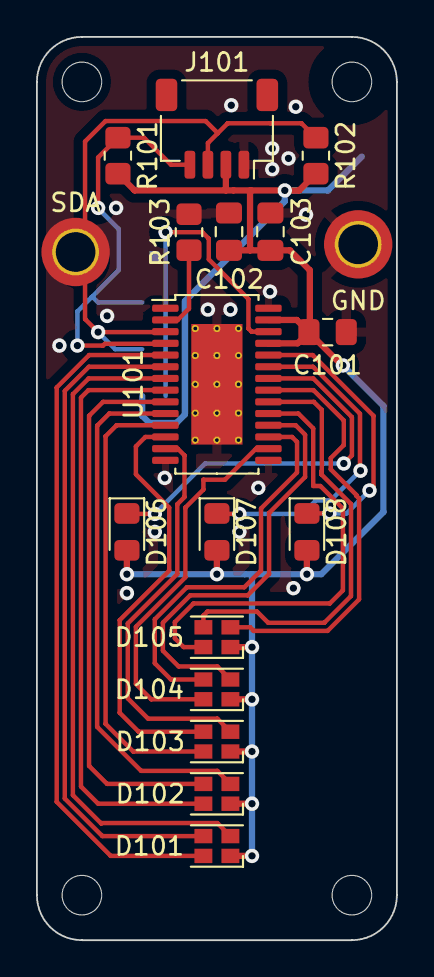
[picture p12: board Transmit LEDs.kicad_pcb from above]

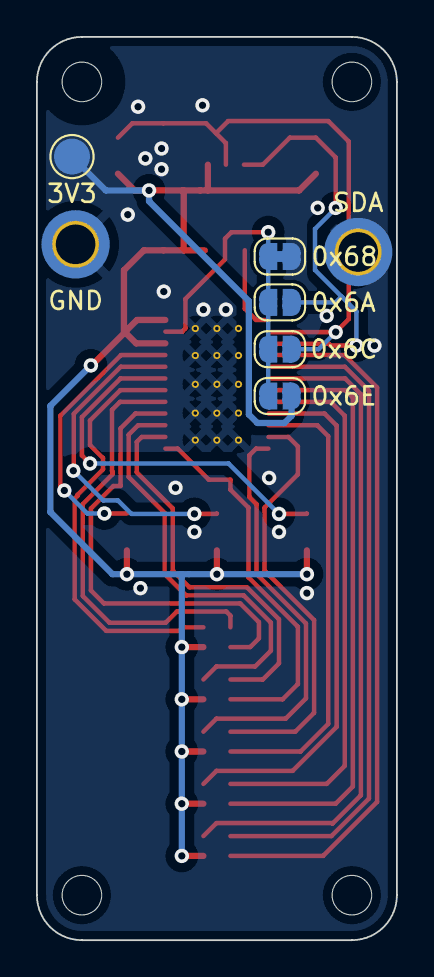
[picture p13: board Transmit LEDs.kicad_pcb from below]

Board: 2 copper layers, 20.0 x 50.2 mm, 27 parts (5 on the bottom side), 24 nets.
