rbrian/uChaser/prototype/Boards/Transmit US/Transmit US.kicad_pcb

## KiCad design prototype/Boards/Transmit US/Transmit US.kicad_pcb (2023-04-07)

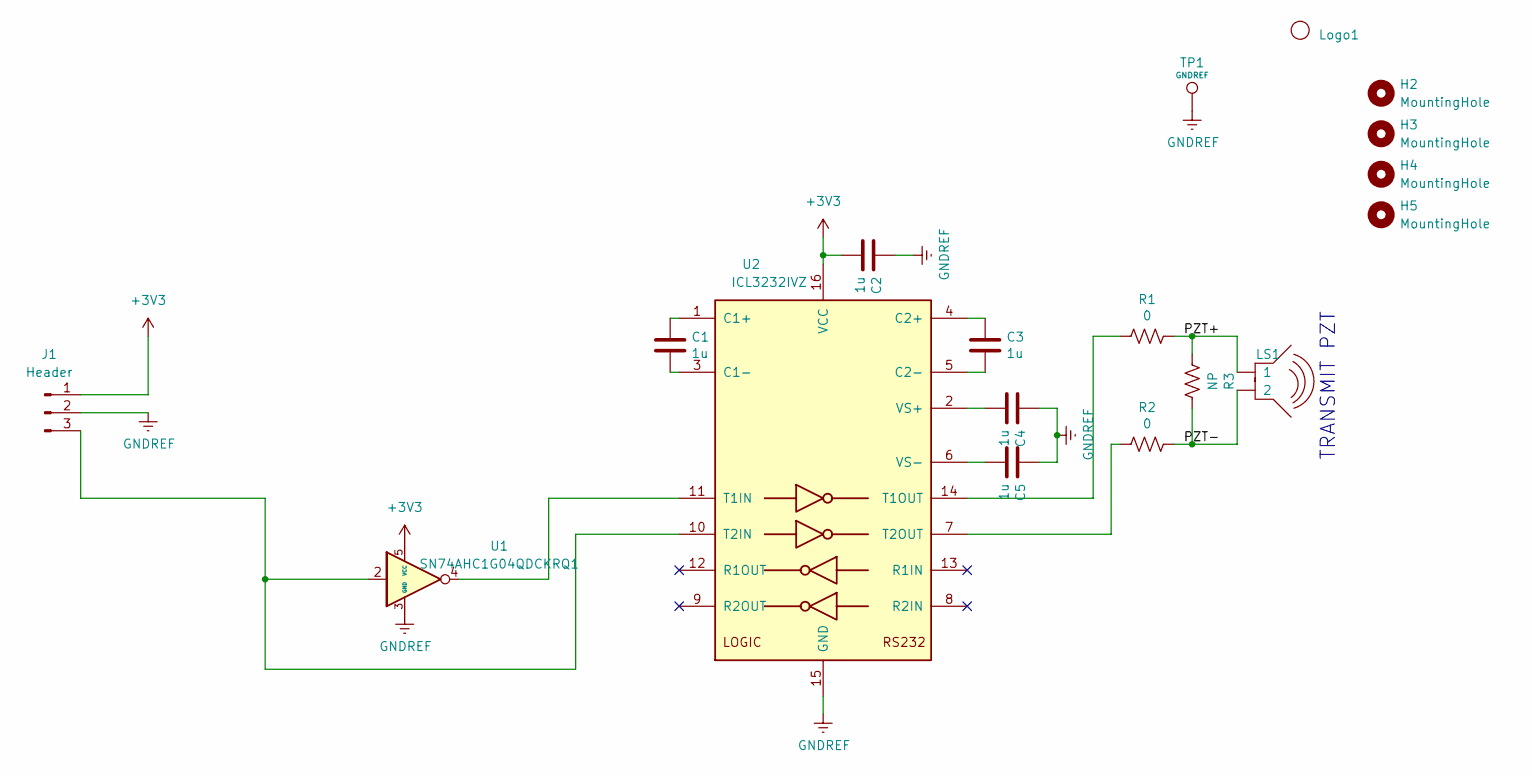
[picture p14: schematic Transmit US.kicad_sch]

Parts:
C1, C2, C3, C4, C5: 1u; C_0603_1608Metric_Pad1.08x0.95mm_HandSolder; MFG PN CL10A105KA8NNNC
H2, H3, H4, H5: MountingHole; MountingHole_3.2mm_M3
J1: Header; PinHeader_1x03_P2.54mm_Vertical
LS1: USTransducer; ULTRASONIC_16MM
Logo1: uFollowLogo
R1, R2: 0; R_0603_1608Metric_Pad0.98x0.95mm_HandSolder; MFG PN RC0603FR-070RL
R3: NP; R_0603_1608Metric_Pad0.98x0.95mm_HandSolder; MFG PN NA
TP1: TestPoint; TestPoint_Keystone_5005-5009_Compact; MFG PN 1041
U1: SN74AHC1G04QDCKRQ1; SOT-353_SC-70-5_Handsoldering; MFG PN SN74AHC1G04QDCKRQ1
U2: ICL3232IVZ; TSSOP-16_4.4x5mm_P0.65mm; MFG PN ICL3232IVZ

Connections:
+3V3: C2.1, J1.1, U1.5 (VCC), U2.16 (VCC)
/PZT+: LS1.1, R1.2, R3.2
/PZT-: LS1.2, R2.2, R3.1
GNDREF: C2.2, C4.2, C5.2, J1.2, TP1.1, U1.3 (GND), U2.15 (GND)
unnamed: J1.3, U1.2, U2.10 (T2IN)
unnamed: C1.2, U2.1 (C1+)
unnamed: C1.1, U2.3 (C1-)
unnamed: C3.2, U2.4 (C2+)
unnamed: C3.1, U2.5 (C2-)
unnamed: U1.4, U2.11 (T1IN)
unnamed: R1.1, U2.14 (T1OUT)
unnamed: R2.1, U2.7 (T2OUT)
unnamed: C4.1, U2.2 (VS+)
unnamed: C5.1, U2.6 (VS-)

Notes on the sheet:
TRANSMIT PZT

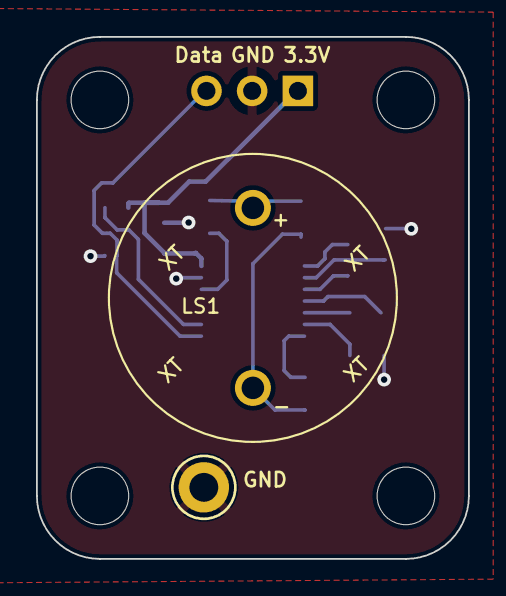
[picture p15: board Transmit US.kicad_pcb from above]

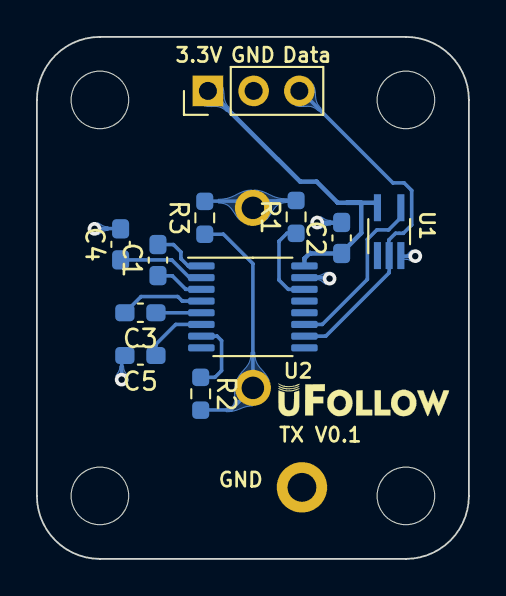
[picture p16: board Transmit US.kicad_pcb from below]

Board: 2 copper layers, 24.0 x 29.0 mm, 18 parts (12 on the bottom side), 14 nets.
