rbrian/uChaser/prototype/Boards/Receive MCU/receive mcu prototype r1/power.kicad_sch

## KiCad design prototype/Boards/Receive MCU/receive mcu prototype r1/power.kicad_sch (2023-04-07)

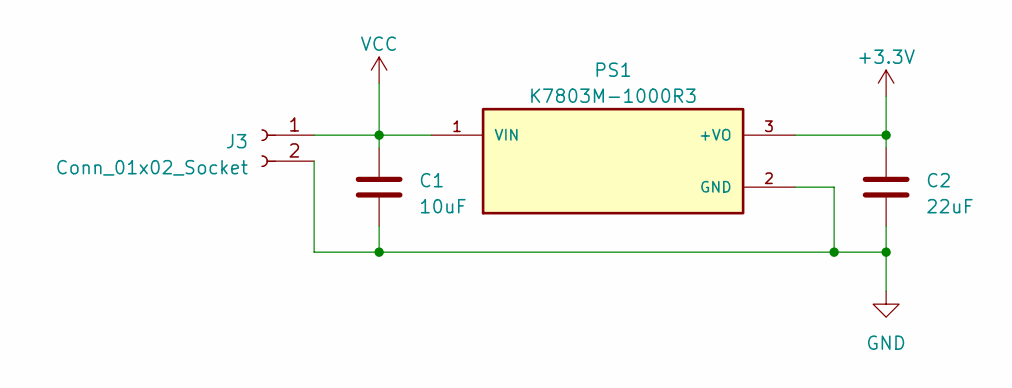
[picture p17: schematic power.kicad_sch]

Parts:
C1: 10uF; C_0805_2012Metric
C2: 22uF; C_0805_2012Metric
J3: Conn_01x02_Socket; JST_XH_B2B-XH-A_1x02_P2.50mm_Vertical
PS1: K7803M-1000R3; CONV_K7803M-1000R3; PARTREV 2020.01.08-A/5

Connections:
+3.3V: C2.1, PS1.3 (+VO)
GND: C1.2, C2.2, J3.2, PS1.2 (GND)
VCC: C1.1, J3.1, PS1.1 (VIN)
