rbrian/uChaser/prototype/Boards/Receive MCU/receive mcu prototype r1/receive mcu prototype r1.kicad_sch

## KiCad design prototype/Boards/Receive MCU/receive mcu prototype r1/receive mcu prototype r1.kicad_sch (2023-04-09)

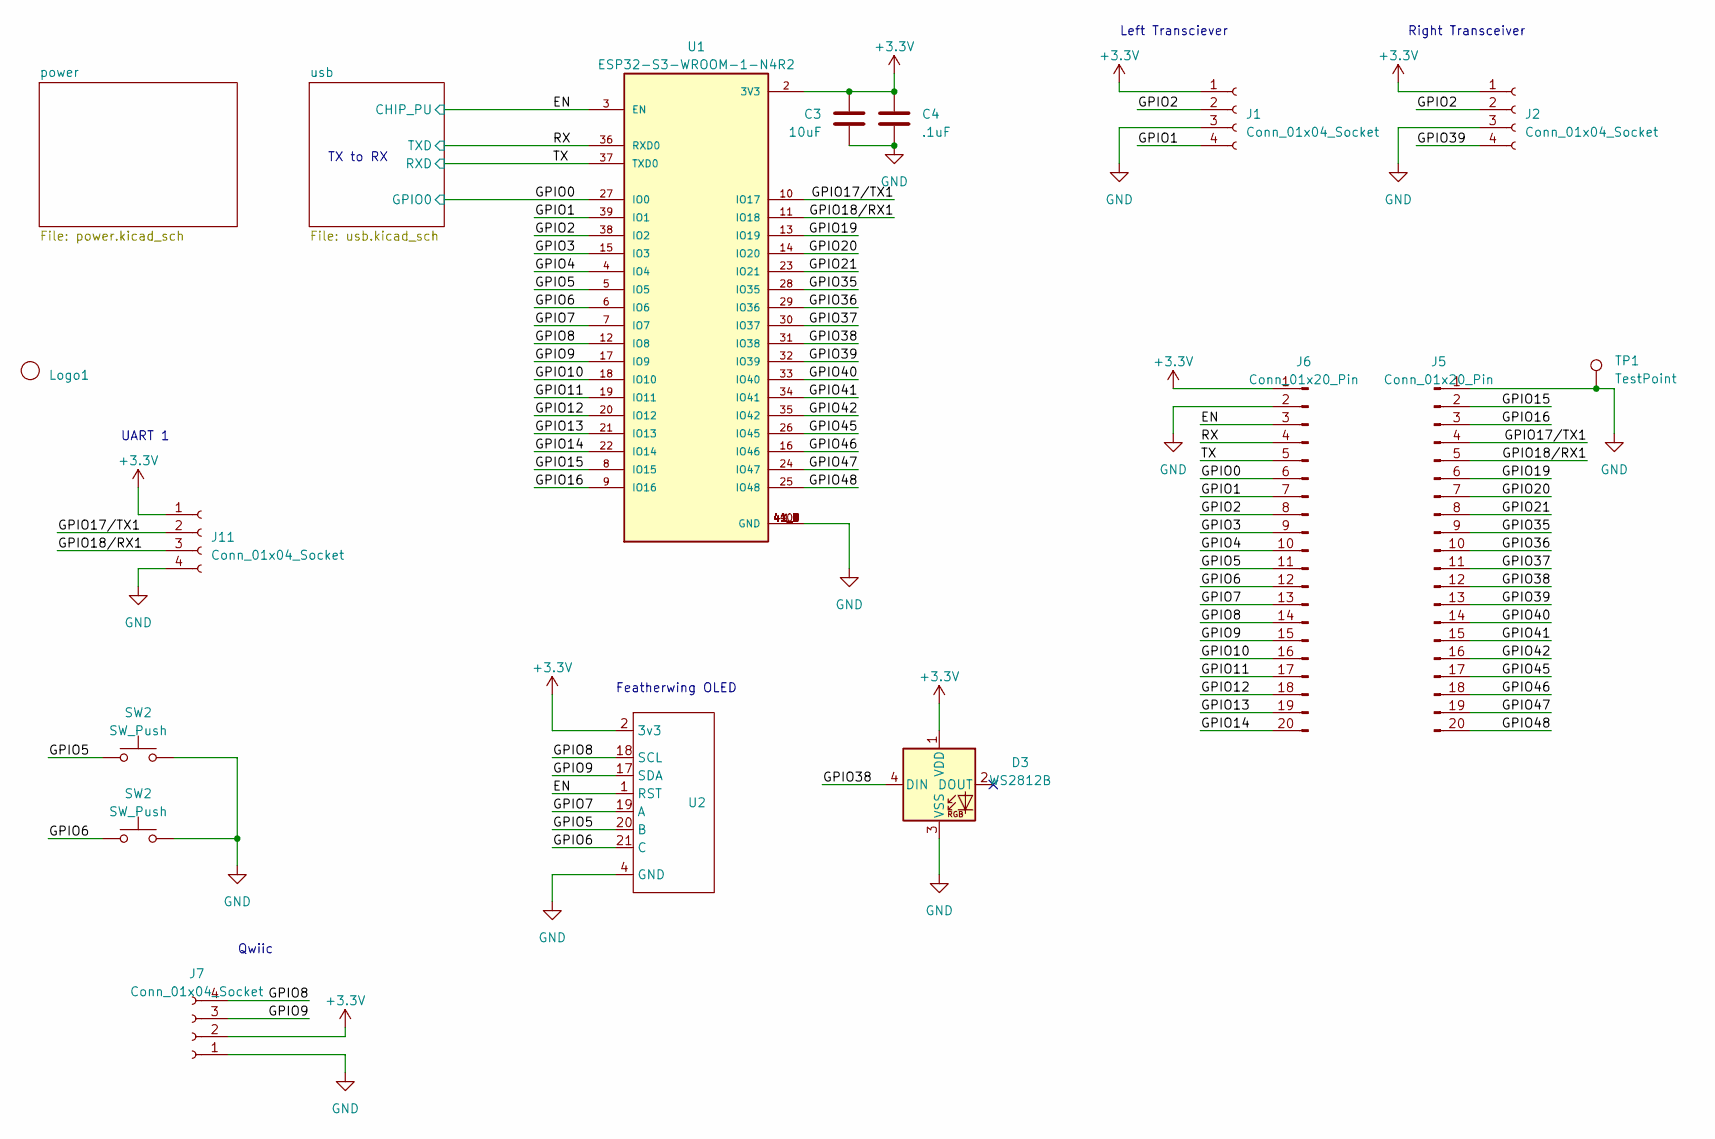
[picture p18: schematic receive mcu prototype r1.kicad_sch]

Parts:
C3: 10uF; C_0805_2012Metric
C4: .1uF; C_0805_2012Metric
D3: WS2812B; LED_WS2812B_PLCC4_5.0x5.0mm_P3.2mm
J1, J2, J11: Conn_01x04_Socket; JST_XH_B4B-XH-A_1x04_P2.50mm_Vertical
J5, J6: Conn_01x20_Pin; PinHeader_1x20_P2.54mm_Vertical
J7: Conn_01x04_Socket; JST_SH_SM04B-SRSS-TB_1x04-1MP_P1.00mm_Horizontal
Logo1: uFollowLogo
SW2: SW_Push; SW_TH_Tactile_Omron_B3F-10xx
TP1: TestPoint; PinHeader_1x01_P2.54mm_Vertical
U1: ESP32-S3-WROOM-1-N4R2; XCVR_ESP32-S3-WROOM-1-N4R2; PARTREV v1.0
U2: Adafruit_Feather

Connections:
+3.3V: C3.1, C4.1, D3.1 (VDD), J1.1, J2.1, J6.1, J7.2, J11.1, U1.2 (3V3), U2.2 (3v3)
EN: J6.3, U1.3 (EN), U2.1 (RST)
GND: C3.2, C4.2, D3.3 (VSS), J1.3, J2.3, J5.1, J6.2, J7.1, J11.4, SW2.2, TP1.1, U1.1 (GND), U1.40 (GND), U1.41_1 (GND), U1.41_2 (GND), U1.41_3 (GND), U1.41_4 (GND), U1.41_5 (GND), U1.41_6 (GND), U1.41_7 (GND), U1.41_8 (GND), U1.41_9 (GND), U2.4 (GND)
GPIO0: J6.6, U1.27 (IO0)
GPIO1: J1.4, J6.7, U1.39 (IO1)
GPIO2: J1.2, J2.2, J6.8, U1.38 (IO2)
GPIO3: J6.9, U1.15 (IO3)
GPIO4: J6.10, U1.4 (IO4)
GPIO5: J6.11, SW2.1, U1.5 (IO5), U2.20 (B)
GPIO6: J6.12, SW2.1, U1.6 (IO6), U2.21 (C)
GPIO7: J6.13, U1.7 (IO7), U2.19 (A)
GPIO8: J6.14, J7.4, U1.12 (IO8), U2.18 (SCL)
GPIO9: J6.15, J7.3, U1.17 (IO9), U2.17 (SDA)
GPIO10: J6.16, U1.18 (IO10)
GPIO11: J6.17, U1.19 (IO11)
GPIO12: J6.18, U1.20 (IO12)
GPIO13: J6.19, U1.21 (IO13)
GPIO14: J6.20, U1.22 (IO14)
GPIO15: J5.2, U1.8 (IO15)
GPIO16: J5.3, U1.9 (IO16)
GPIO17/TX1: J5.4, J11.2, U1.10 (IO17)
GPIO18/RX1: J5.5, J11.3, U1.11 (IO18)
GPIO19: J5.6, U1.13 (IO19)
GPIO20: J5.7, U1.14 (IO20)
GPIO21: J5.8, U1.23 (IO21)
GPIO35: J5.9, U1.28 (IO35)
GPIO36: J5.10, U1.29 (IO36)
GPIO37: J5.11, U1.30 (IO37)
GPIO38: D3.4 (DIN), J5.12, U1.31 (IO38)
GPIO39: J2.4, J5.13, U1.32 (IO39)
GPIO40: J5.14, U1.33 (IO40)
GPIO41: J5.15, U1.34 (IO41)
GPIO42: J5.16, U1.35 (IO42)
GPIO45: J5.17, U1.26 (IO45)
GPIO46: J5.18, U1.16 (IO46)
GPIO47: J5.19, U1.24 (IO47)
GPIO48: J5.20, U1.25 (IO48)
RX: J6.4, U1.36 (RXD0)
TX: J6.5, U1.37 (TXD0)

Notes on the sheet:
Featherwing OLED
UART 1
Left Transciever
Qwiic
Right Transceiver
TX to RX
