rbrian/uChaser/prototype/Boards/Receive MCU/receive mcu prototype r1/usb.kicad_sch

## KiCad design prototype/Boards/Receive MCU/receive mcu prototype r1/usb.kicad_sch (2023-04-09)

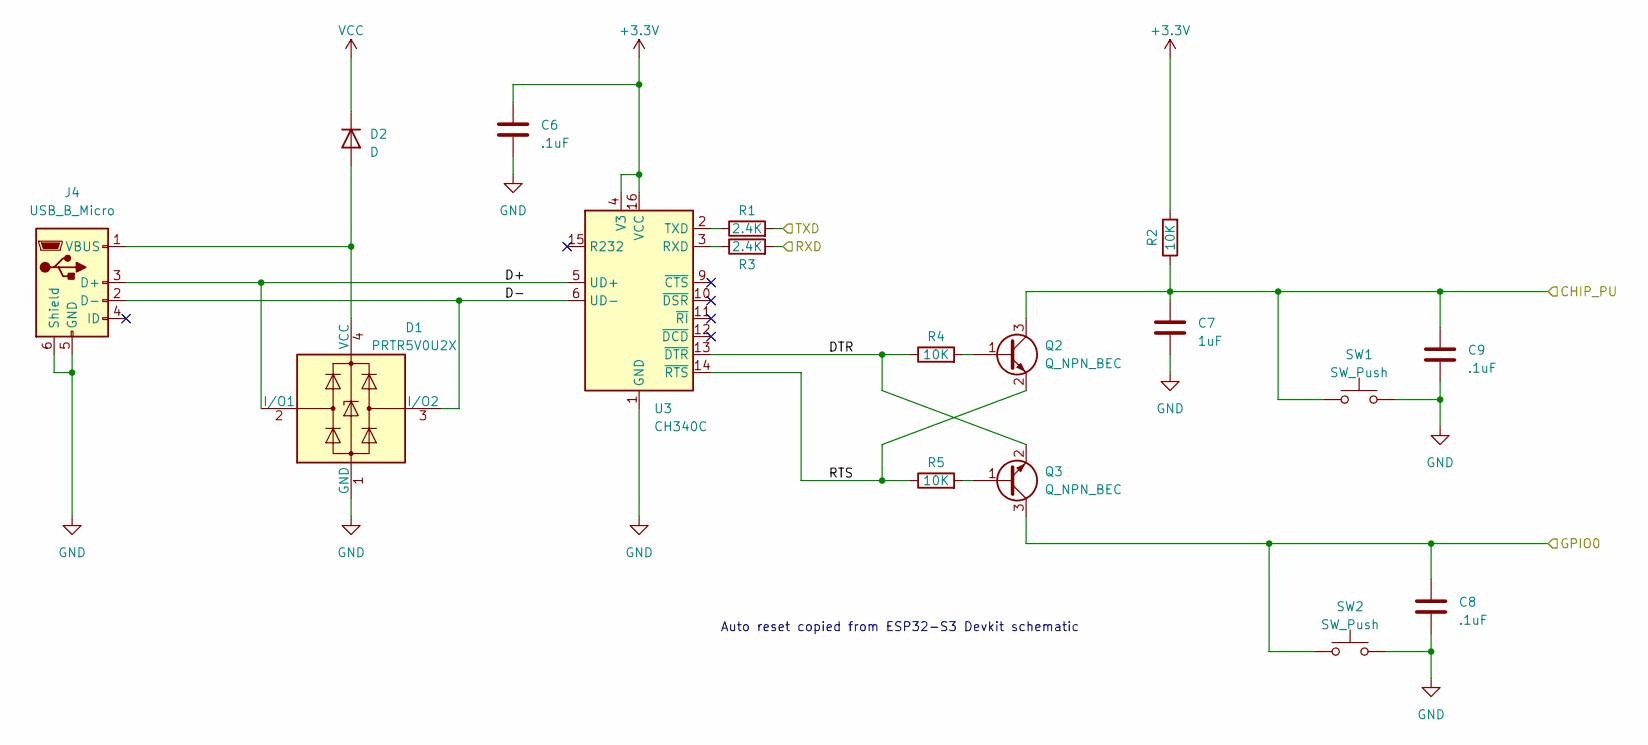
[picture p19: schematic usb.kicad_sch]

Parts:
C6, C8, C9: .1uF; C_0805_2012Metric
C7: 1uF; C_0805_2012Metric
D1: PRTR5V0U2X; SOT-143; LCSC C2827688
D2: D; D_SOD-123; LCSC C64898
J4: USB_B_Micro; USB_Micro-B_Amphenol_10118194_Horizontal; LCSC C132563
Q2, Q3: Q_NPN_BEC; SOT-23; LCSC C20526
R1, R3: 2.4K; R_0805_2012Metric; LCSC C17526
R2, R4, R5: 10K; R_0805_2012Metric; LCSC C17414
SW1, SW2: SW_Push; SW_TH_Tactile_Omron_B3F-10xx
U3: CH340C; SOIC-16_3.9x9.9mm_P1.27mm; LCSC C84681

Connections:
+3.3V: C6.1, R2.2, U3.4 (V3), U3.16 (VCC)
CHIP_PU: C7.1, C9.1, Q2.3 (C), R2.1, SW1.1
D+: D1.2 (I/O1), J4.3 (D+), U3.5 (UD+)
D-: D1.3 (I/O2), J4.2 (D-), U3.6 (UD-)
DTR: Q3.2 (E), R4.1, U3.13 (~DTR)
GND: C6.2, C7.2, C8.2, C9.2, D1.1 (GND), J4.5 (GND), J4.6 (Shield), SW1.2, SW2.2, U3.1 (GND)
GPIO0: C8.1, Q3.3 (C), SW2.1
unnamed: D1.4 (VCC), D2.2 (A), J4.1 (VBUS)
unnamed: Q2.1 (B), R4.2
unnamed: Q3.1 (B), R5.2
unnamed: R1.1, U3.2 (TXD)
unnamed: R3.1, U3.3 (RXD)
RTS: Q2.2 (E), R5.1, U3.14 (~RTS)
RXD: R3.2
TXD: R1.2
VCC: D2.1 (K)

Notes on the sheet:
Auto reset copied from ESP32-S3 Devkit schematic
