rbrian/uChaser/(commit log)

2023-04-07 Copy existing boards into new repo
    [Receive US-B_Cu.gbl, Receive US-B_Mask.gbs, Receive US-B_Paste.gbp, Receive US-B_Silkscreen.gbo, Receive US-Edge_Cuts.gko, Receive US-F_Cu.gtl, Receive US-F_Mask.gts, Receive US-F_Paste.gtp]
2023-04-07 Update logo on receiver board; add new logo footprint & symbol
    [Receive US.kicad_pcb, Receive US.kicad_sch]
2023-04-07 Adjustments to new logo
    [Receive US.kicad_pcb, Transmit US.kicad_pcb, Transmit US.kicad_sch]
2023-04-07 pdf of 0.1 receive board
2023-04-07 mcu prototype board r1
    [ESP32-S3-WROOM-1-N4R2.step, power.kicad_sch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]
2023-04-09 gerbers and few updates
    [receive mcu prototype r1-B_Cu.gbr, receive mcu prototype r1-B_Mask.gbr, receive mcu prototype r1-B_Paste.gbr, receive mcu prototype r1-B_Silkscreen.gbr, receive mcu prototype r1-Edge_Cuts.gbr, receive mcu prototype r1-F_Cu.gbr, receive mcu prototype r1-F_Mask.gbr, receive mcu prototype r1-F_Paste.gbr]
2023-04-10 receiver board v2
    [Receive US v2.kicad_pcb, Receive US v2.kicad_sch]
2023-04-10 First stage reorganization; adding web server stuff
2023-04-11 Recv V2 layout
    [Receive US v2.kicad_pcb, Receive US v2.kicad_sch]
2023-04-11 Clean up pours
    [Receive US v2.kicad_pcb]
2023-04-13 my board
    [Receive US v2 elliot-panel.kicad_pcb, Receive US v2 elliot.kicad_pcb, Receive US v2 elliot.kicad_sch, bom.csv, designators.csv, positions.csv]
2023-04-13 readme update
    [bom.csv, designators.csv, positions.csv]
2023-04-14 make all current objects singletons
2023-04-17 Got LED, SPIFFS, JSON read, WIFI, and webserver working
2023-04-21 UART output for receiver
2023-04-21 Updated pin and board definition for transmitter
2023-05-09 Reorganize & clean up repository
    [Receive US v2 elliot-panel.kicad_pcb, Receive US v2 elliot.kicad_pcb, Receive US v2 elliot.kicad_sch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]
2023-05-11 fix missing receive board
    [Receive US v2.kicad_pcb, Receive US v2.kicad_sch]
2023-05-11 Restore 2 versions of receive board
